gameboycamera/NES-controller-to-GB-linkport/assets/diagram.jpg

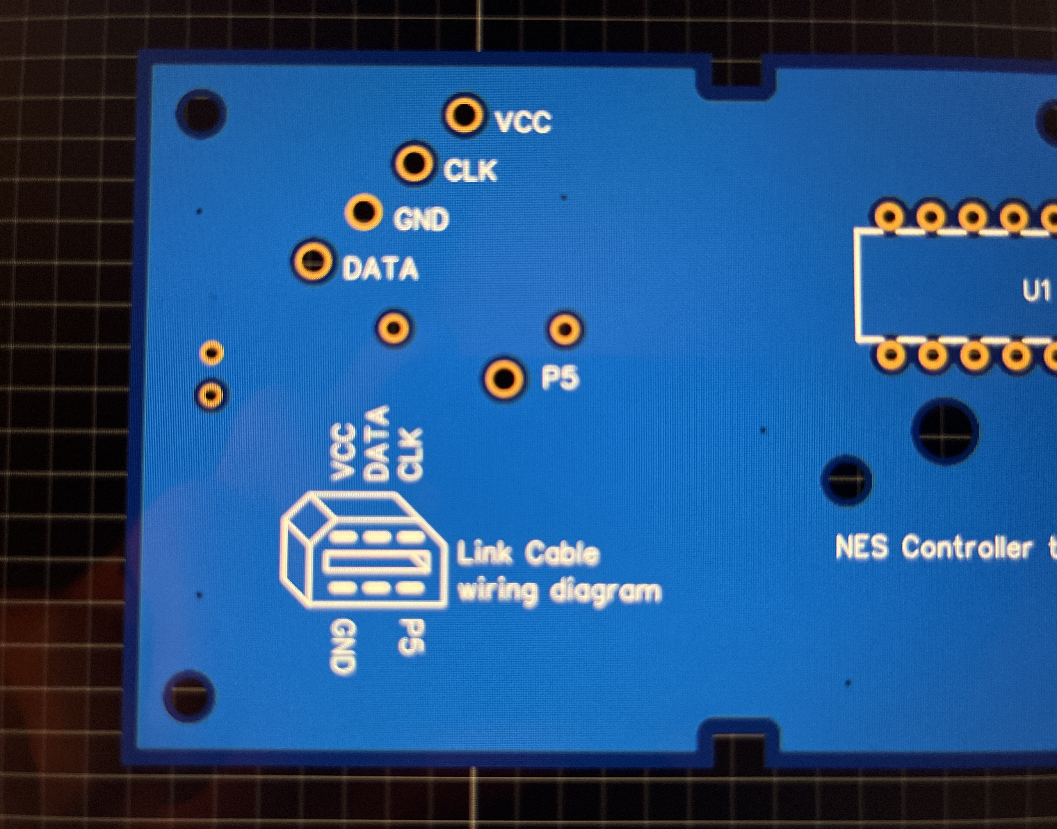
assets/diagram.jpg
