gameboycamera/NES-controller-to-GB-linkport/assets/resistorled.png

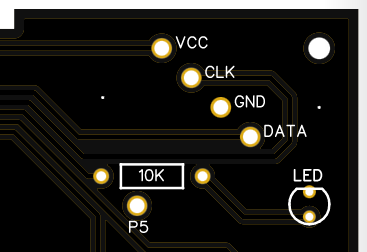
assets/resistorled.png
